cccc/U23_2017_Hardware/doku/readme.txt

Bestückungsplan mit "lualatex --shell-esc components.tex" compilieren
