cccc/U23_2017_Hardware/doku/schematic.pdf

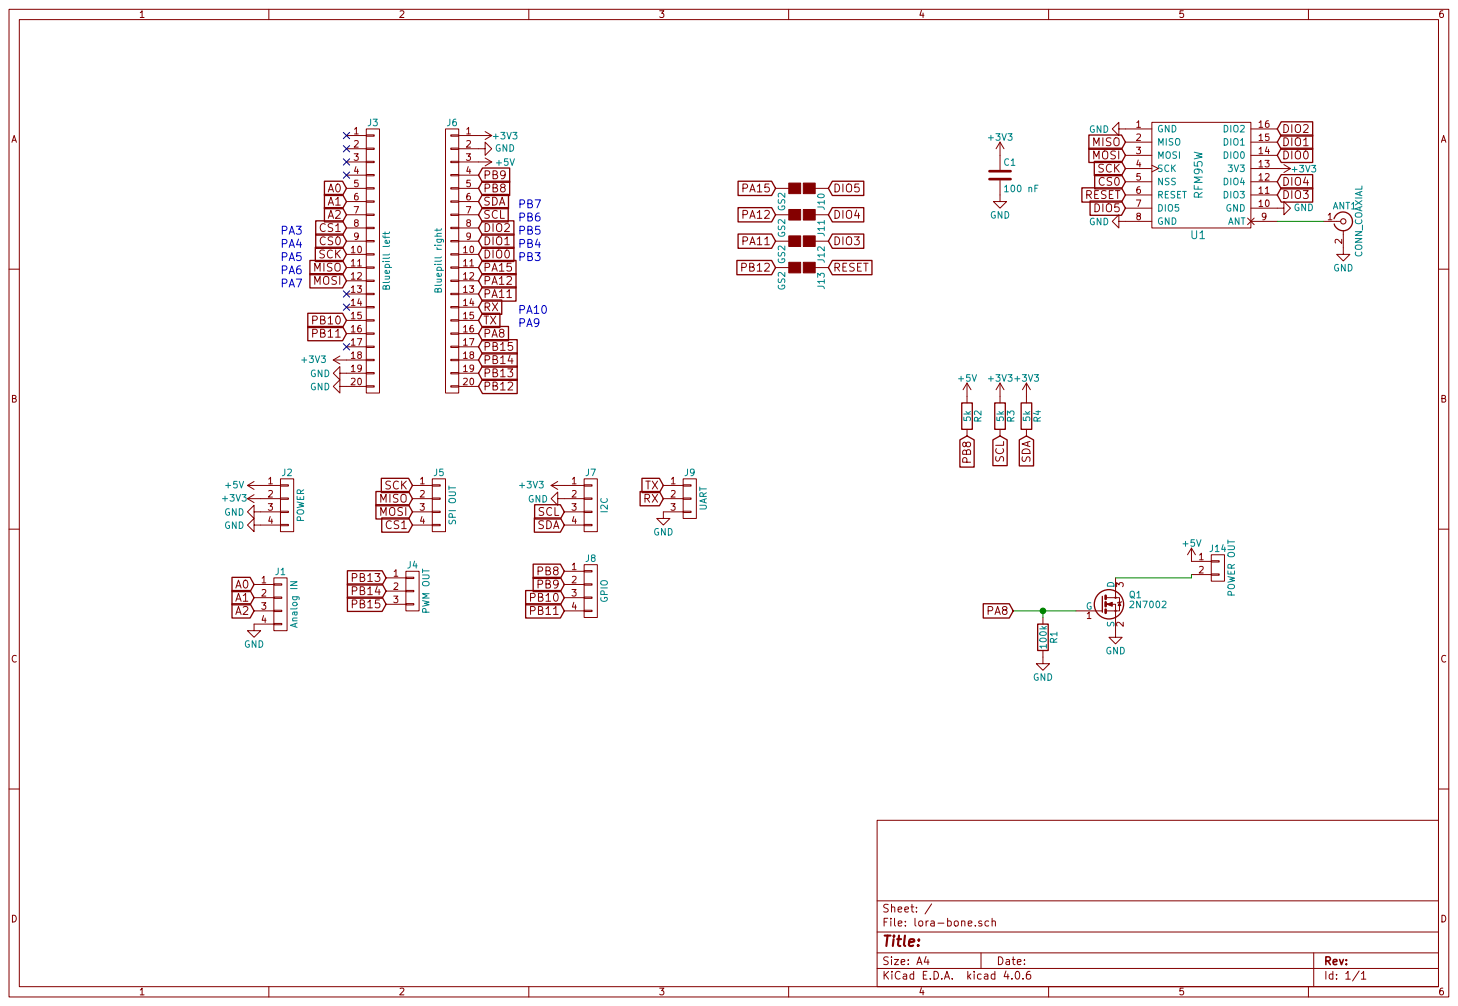
[picture p2: page 1]

Id: 1/1 Title: File: lora-bone.sch Sheet: /
