cccc/U23_2017_Hardware/lora-bone.kicad_pcb

## KiCad design lora-bone.kicad_pcb (2017-10-16)

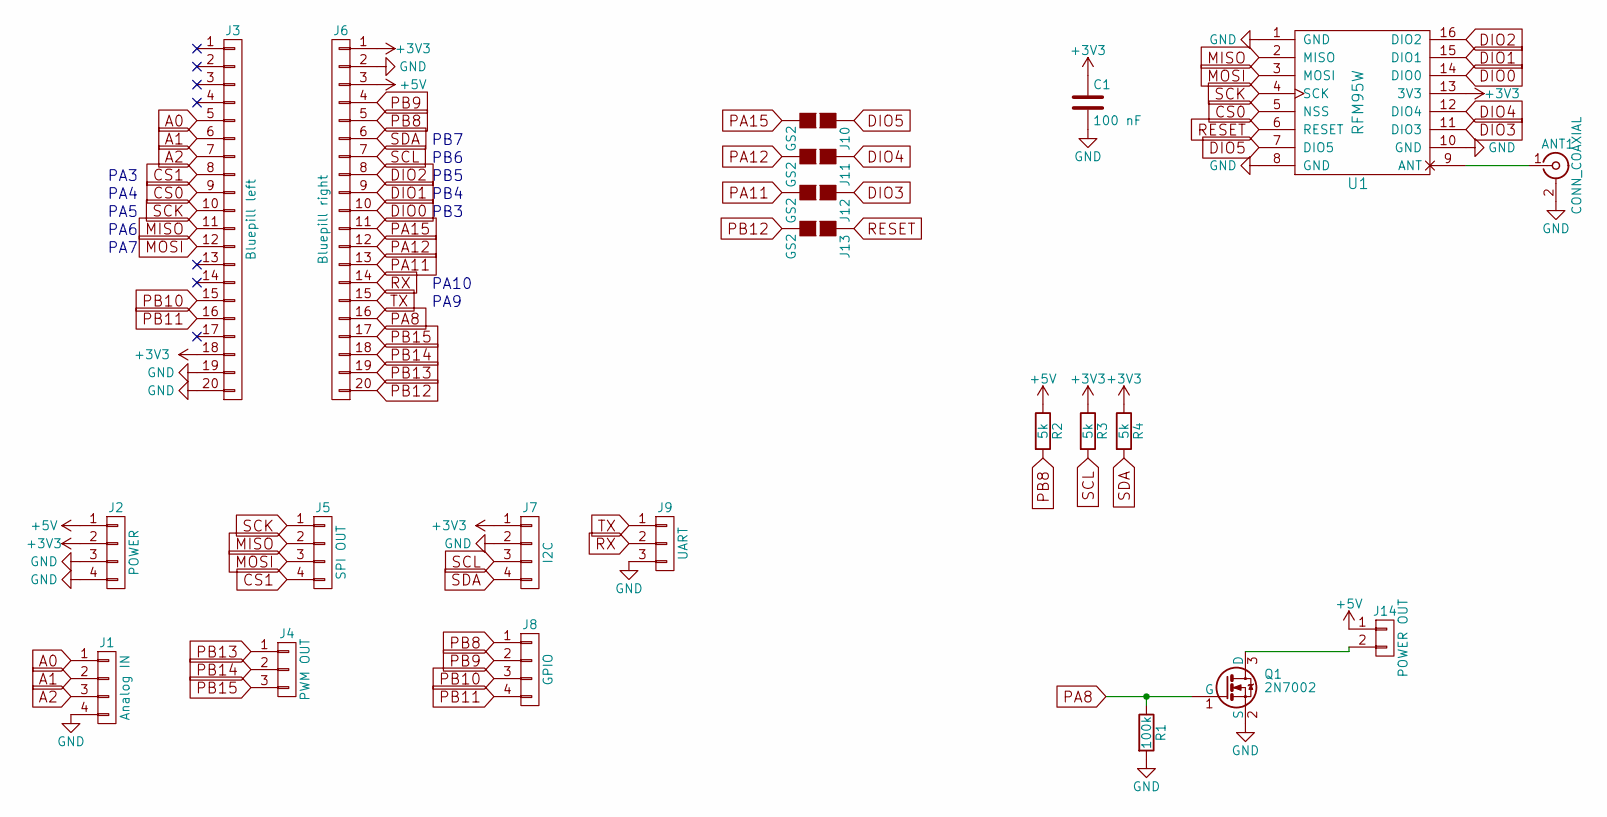
[picture p3: schematic lora-bone.sch]

Parts:
ANT1: CONN_COAXIAL; SMA_THT_Jack_Straight
C1: 100 nF; C_0805_HandSoldering
J1: Analog IN; Pin_Header_Straight_1x04_Pitch2.54mm
J2: POWER; Pin_Header_Straight_1x04_Pitch2.54mm
J3: Bluepill left; Pin_Header_Straight_1x20_Pitch2.54mm
J4: PWM OUT; Pin_Header_Straight_1x03_Pitch2.54mm
J5: SPI OUT; Pin_Header_Straight_1x04_Pitch2.54mm
J6: Bluepill right; Pin_Header_Straight_1x20_Pitch2.54mm
J7: I2C; Pin_Header_Straight_1x04_Pitch2.54mm
J8: GPIO; Pin_Header_Straight_1x04_Pitch2.54mm
J9: UART; Pin_Header_Straight_1x03_Pitch2.54mm
J10, J11, J12, J13: GS2
J14: POWER OUT; Pin_Header_Straight_1x02_Pitch2.54mm
Q1: 2N7002; SOT-23_Handsoldering
R1: 100k; R_0805_HandSoldering
R2, R3, R4: 5k; R_0805_HandSoldering
U1: RFM95W; RFM95W_SMD

Connections:
+3V3: C1.1, J2.2, J3.18, J6.1, J7.1, R3.1, R4.1, U1.13 (3V3)
+5V: J2.1, J6.3, J14.1, R2.1
A0: J1.1, J3.5
A1: J1.2, J3.6
A2: J1.3, J3.7
CS0: J3.9, U1.5 (NSS)
CS1: J3.8, J5.4
DIO0: J6.10, U1.14 (DIO0)
DIO1: J6.9, U1.15 (DIO1)
DIO2: J6.8, U1.16 (DIO2)
DIO3: J12.1 (G1), U1.11 (DIO3)
DIO4: J11.1 (G1), U1.12 (DIO4)
DIO5: J10.1 (G1), U1.7 (DIO5)
GND: ANT1.2 (Ext), C1.2, J1.4, J2.3, J2.4, J3.19, J3.20, J6.2, J7.2, J9.3, Q1.2 (S), R1.2, U1.1 (GND), U1.8 (GND), U1.10 (GND)
MISO: J3.11, J5.2, U1.2 (MISO)
MOSI: J3.12, J5.3, U1.3 (MOSI)
unnamed: ANT1.1 (In), U1.9 (ANT)
unnamed: J14.2, Q1.3 (D)
PA8: J6.16, Q1.1 (G), R1.1
PA11: J6.13, J12.2 (G2)
PA12: J6.12, J11.2 (G2)
PA15: J6.11, J10.2 (G2)
PB8: J6.5, J8.1, R2.2
PB9: J6.4, J8.2
PB10: J3.15, J8.3
PB11: J3.16, J8.4
PB12: J6.20, J13.2 (G2)
PB13: J4.1, J6.19
PB14: J4.2, J6.18
PB15: J4.3, J6.17
RESET: J13.1 (G1), U1.6 (RESET)
RX: J6.14, J9.2
SCK: J3.10, J5.1, U1.4 (SCK)
SCL: J6.7, J7.3, R3.2
SDA: J6.6, J7.4, R4.2
TX: J6.15, J9.1

Notes on the sheet:
PA7
PA6
PA5
PA4
PA3
PB7
PB6
PB5
PB3
PB4
PA10
PA9

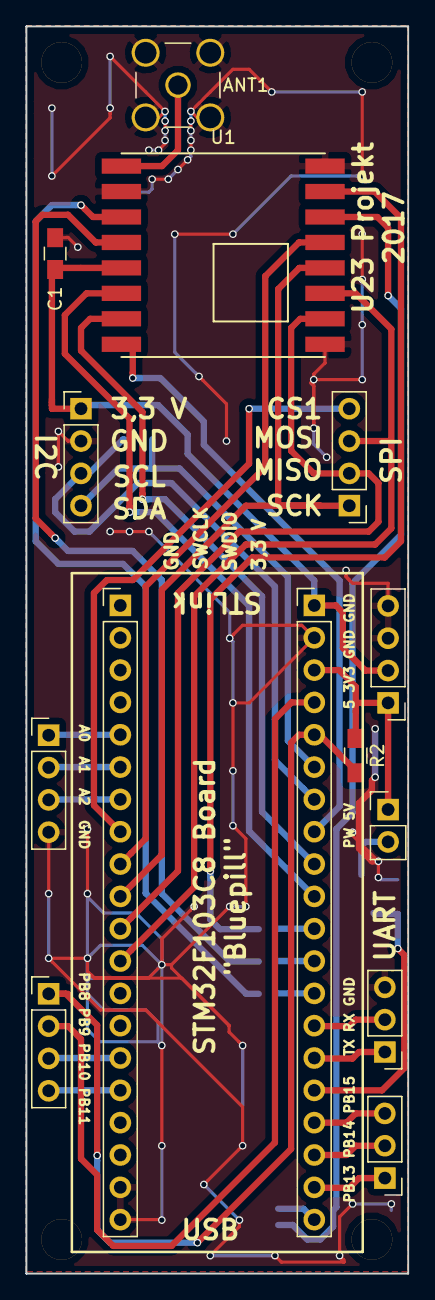
[picture p4: board lora-bone.kicad_pcb from above]

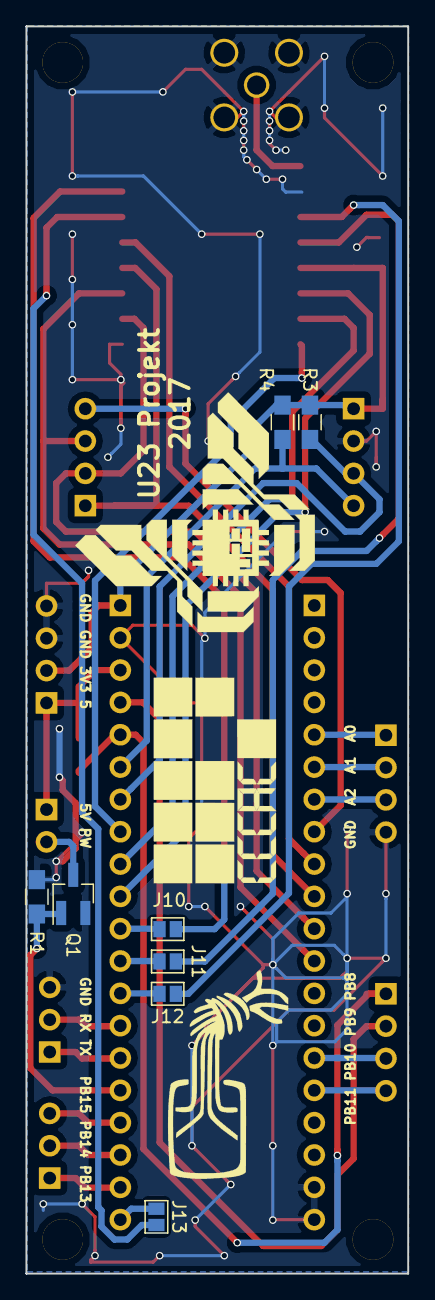
[picture p5: board lora-bone.kicad_pcb from below]

Board: 2 copper layers, 30.0 x 98.0 mm, 22 parts (8 on the bottom side), 36 nets.
