cccc/U23_2017_Hardware/(commit log)

2017-09-03 Initial Commit
    Did already most of PCB Design. Some Labels are missing. Maybe an "Power GPIO" will be added by Ike
    [lora-bone.kicad_pcb, lora-bone.sch]
2017-09-04 More Labeles for Breakout Header
    [lora-bone.kicad_pcb]
2017-09-04 A few little corrections
    [lora-bone.kicad_pcb, lora-bone.sch]
2017-09-04 Nicer Ground Planes, nicer Via placements, hopefully better Ground Distribution :>
    [lora-bone.kicad_pcb]
2017-09-04 More Logos.
    There can never be enough logos. It is not possible to reduce the count of Logos
    [lora-bone.kicad_pcb]
2017-09-04 A few changes and corrections
    [lora-bone.kicad_pcb, lora-bone.sch]
2017-09-04 Add power GPIO hint
    [lora-bone.kicad_pcb, lora-bone.sch]
2017-09-04 Power GPIO routet. Added Pull UP Resistor for PB8
    [lora-bone.kicad_pcb, lora-bone.sch]
2017-09-04 Added Pull Ups for I2C.
    [lora-bone.kicad_pcb, lora-bone.sch]
2017-09-05 moved CCCAC Logo a bit, deactivated one reference
    [lora-bone.kicad_pcb]
2017-09-24 Make the Board 2 mm shorter
    [lora-bone.kicad_pcb]
2017-09-24 Created panelized Gerber Files for dirtypcbs
    [lora-bone.GBL, lora-bone.GBO, lora-bone.GBR, lora-bone.GBS, lora-bone.GTL, lora-bone.GTO, lora-bone.GTS]
2017-09-24 Added the final gerber files and Schematic as PDF
    [lora-bone.GBR]
2017-10-16 Made RFM95W Footprint slighty better for components diagramm
    [lora-bone.kicad_pcb]
2017-10-16 Exported components diagramm as svg
    [lora-bone.kicad_pcb]
2017-10-16 Made Components diagramm with BOM as tex document
2017-10-16 Moved schematics pdf to doku/
2017-10-16 Make rfm95w footprint even better
    [lora-bone.kicad_pcb]
